Astro36/ICE3015-project/resource/project_note_0512.pdf

## 자이로가속도센서 브레드보드 조립

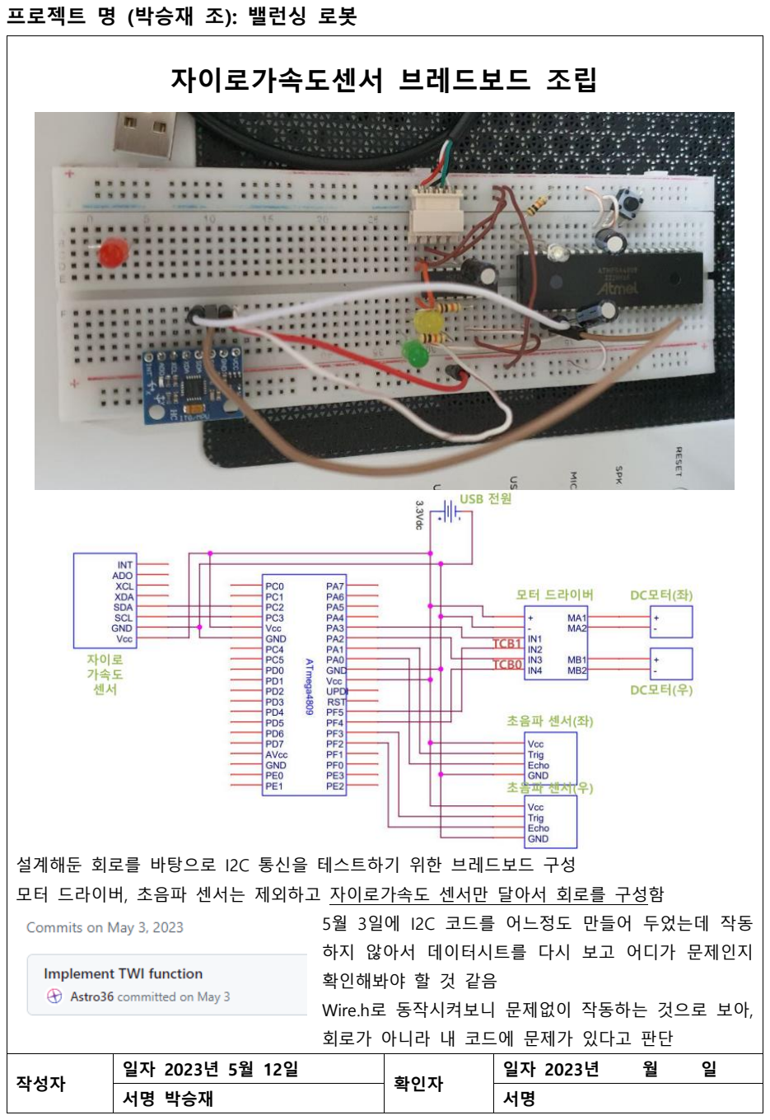
[picture p63: page 1]

프로젝트 명 (박승재 조): 밸런싱 로봇

설계해둔 회로를 바탕으로 I2C 통신을 테스트하기 위한 브레드보드 구성
모터 드라이버, 초음파 센서는 제외하고 자이로가속도 센서만 달아서 회로를 구성함 5월 3일에 I2C 코드를 어느정도 만들어 두었는데 작동 하지 않아서 데이터시트를 다시 보고 어디가 문제인지 확인해봐야 할 것 같음
Wire.h로 동작시켜보니 문제없이 작동하는 것으로 보아, 회로가 아니라 내 코드에 문제가 있다고 판단
작성자 | 일자 2023년 5월 12일 | 확인자 | 일자 2023년 월 일
| 서명 박승재 | | 서명
