Astro36/ICE3015-project/resource/project_note_0524.pdf

## PWM 출력 이슈 해결

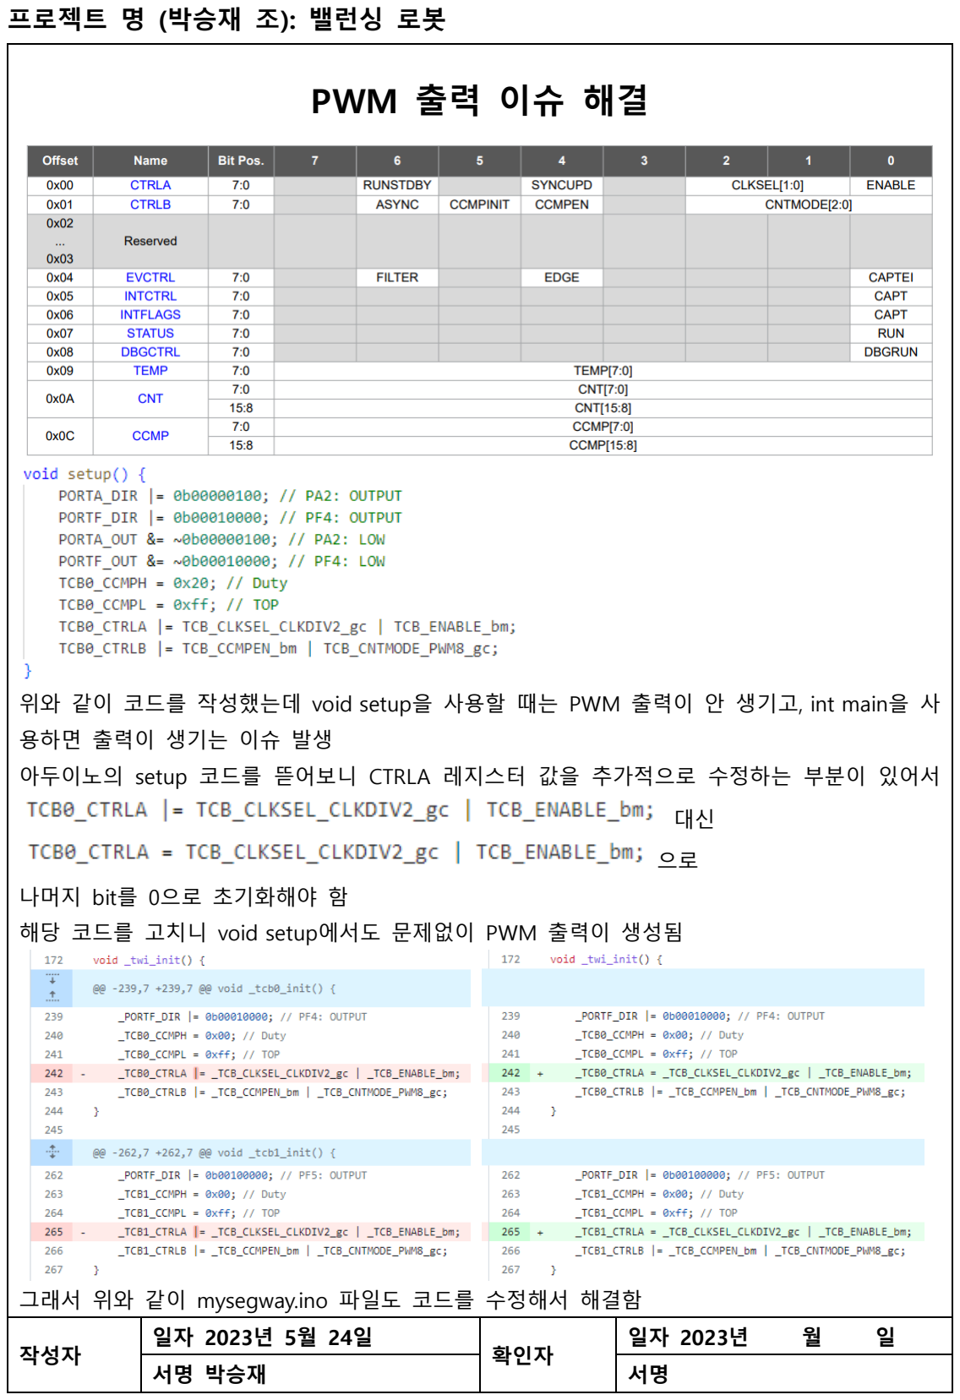
[picture p65: page 1]

프로젝트 명 (박승재 조): 밸런싱 로봇

위와 같이 코드를 작성했는데 void setup을 사용할 때는 PWM 출력이 안 생기고, int main을 사 용하면 출력이 생기는 이슈 발생
아두이노의 setup 코드를 뜯어보니 CTRLA 레지스터 값을 추가적으로 수정하는 부분이 있어서

대신

으로
나머지 bit를 0으로 초기화해야 함
해당 코드를 고치니 void setup에서도 문제없이 PWM 출력이 생성됨

그래서 위와 같이 mysegway.ino 파일도 코드를 수정해서 해결함
작성자 | 일자 2023년 5월 24일 | 확인자 | 일자 2023년 월 일
| 서명 박승재 | | 서명
