Astro36/ICE3015-project/resource/project_note_0604.pdf

## TCA0를 이용한 millis 구현

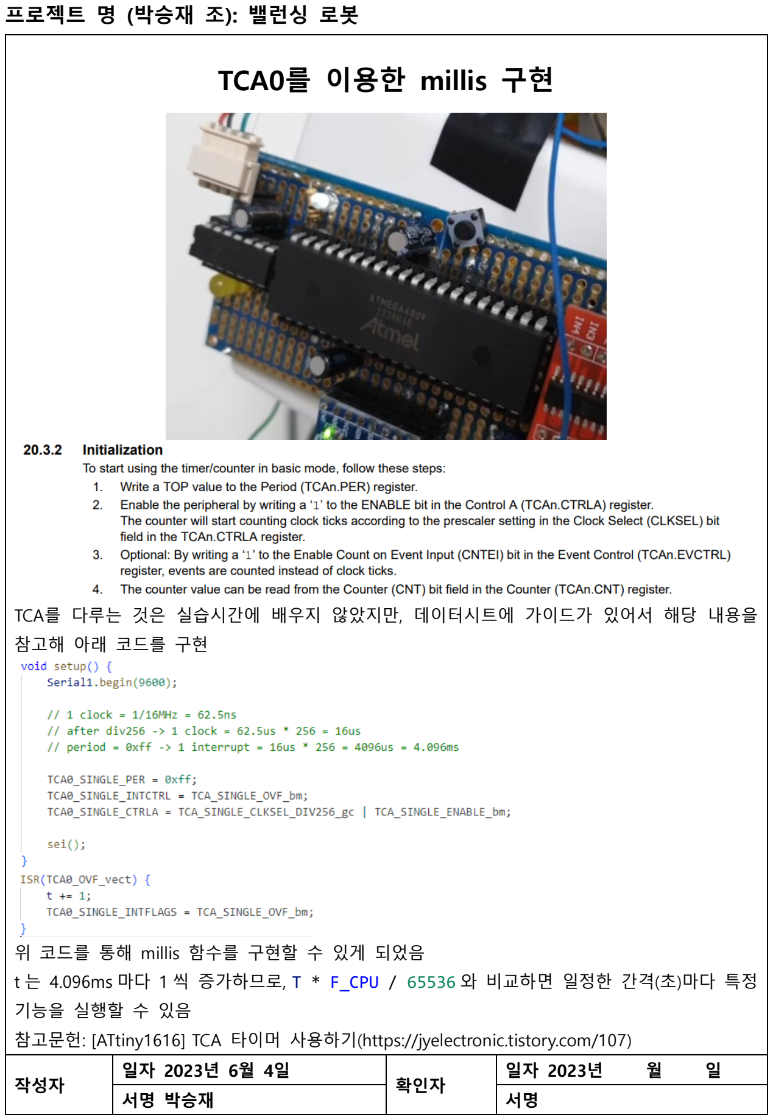
[picture p69: page 1]

프로젝트 명 (박승재 조): 밸런싱 로봇

TCA를 다루는 것은 실습시간에 배우지 않았지만, 데이터시트에 가이드가 있어서 해당 내용을 참고해 아래 코드를 구현

위 코드를 통해 millis 함수를 구현할 수 있게 되었음
t 는 4.096ms 마다 1 씩 증가하므로, T * F_CPU / 65536 와 비교하면 일정한 간격(초)마다 특정 기능을 실행할 수 있음
참고문헌: [ATtiny1616] TCA 타이머 사용하기(https://jyelectronic.tistory.com/107)
작성자 | 일자 2023년 6월 4일 | 확인자 | 일자 2023년 월 일
| 서명 박승재 | | 서명
