Astro36/ICE3015-project/resource/project_note_0613.pdf

프로젝트 명 (박승재 조): 밸런싱 로봇

## 레귤레이터와 배터리 장착, 그리고 전원 불안정

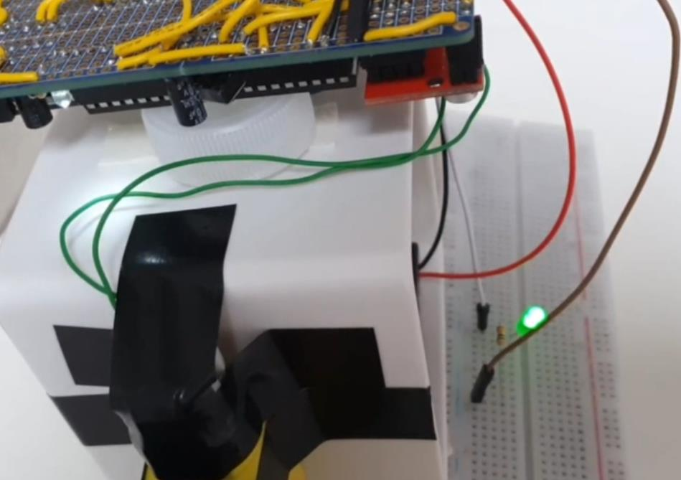
[picture p71: figure]

최종발표를 이틀 앞두고 조교님께 5V 레귤레이터를 받아서 로봇에 장착

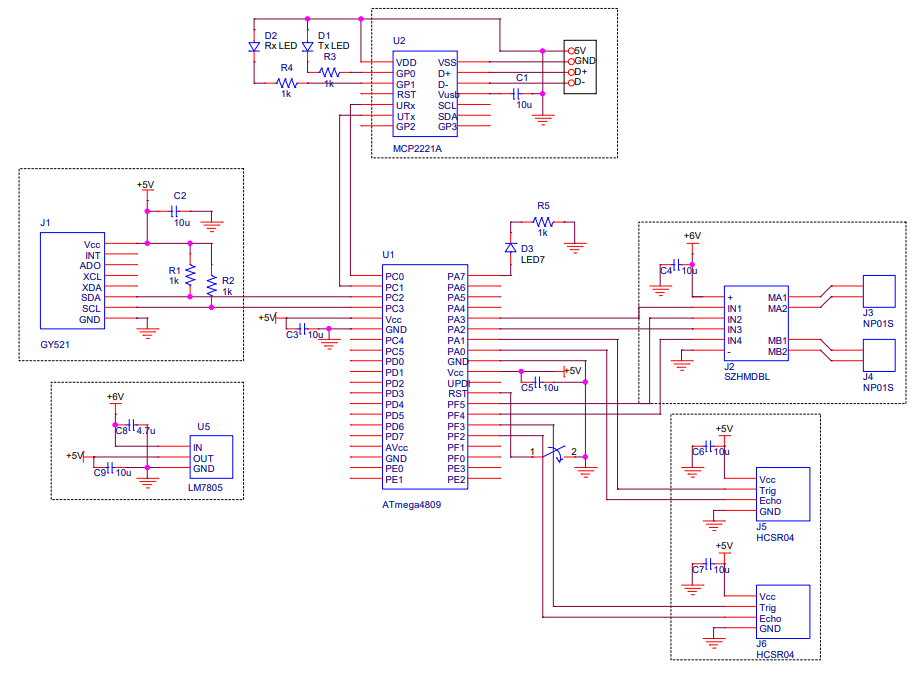
[picture p72: figure]

레귤레이터가 새로 생겼으므로, 회로도를 업데이트 했음
새로운 문제가 생겼는데, 모터를 장착할 때 다이오드를 달지 않아 모터로부터의 역기전력으로 시스템 전체의 전원이 불안정해짐, 모터가 작동하면 MCU가 리셋됨
5월 중 회로 피드백 기간에 발견하지 못한 문제라 상당히 당황스러움
최종발표 중 데모가 가능할 지 확신이 어렵지만 마지막까지 고치려고 시도해볼 예정
작성자 | 일자 2023년 6월 13일 | 확인자 | 일자 2023년 월 일
| 서명 박승재 | | 서명
