Astro36/ICE3015-project/resource/project_note_0609.pdf

프로젝트 명 (박승재 조): 밸런싱 로봇

## 만능기판 납땜 진행

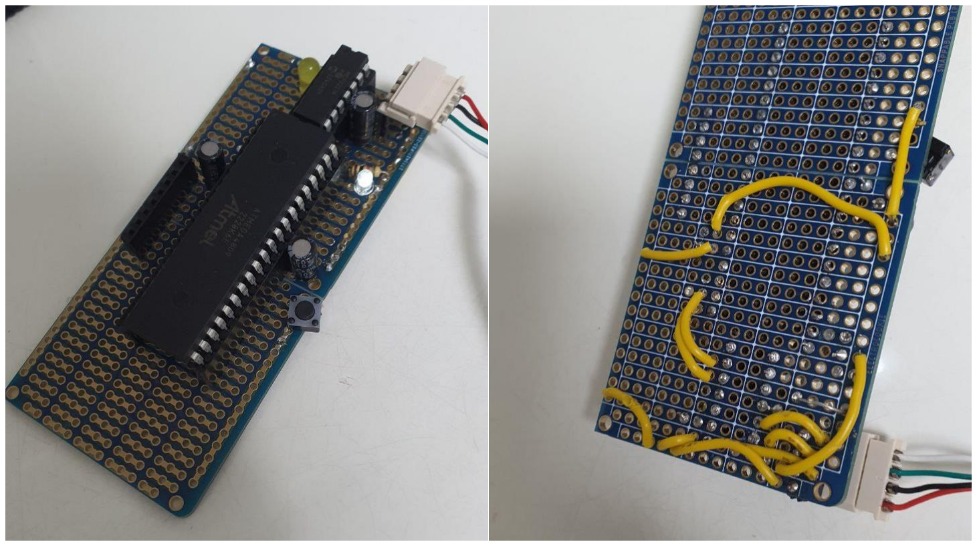
[picture p76: figure]

기존의 만능기판이 납땜 중 파손되어 더 사이즈가 큰 기판으로 다시 주문해서 납땜을 진행함 MCU와 USB 칩만 꽂아서 납땜이 정상적으로 되었는지 확인 후 기타 부품들을 진행

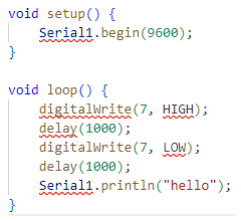
[picture p77: figure]

위 코드는 문제없이 작동하는 것으로 보아, MCU 부분까지는 문제가 없는 것으로 보임 이후 부품들도 납땜 진행 후 조교님께 검사받을 예정
작성자 | 일자 2023년 6월 9일 | 확인자 | 일자 2023년 월 일
| 서명 박승재 | | 서명
