Astro36/ICE3015-project/resource/orcad/circuit.pdf

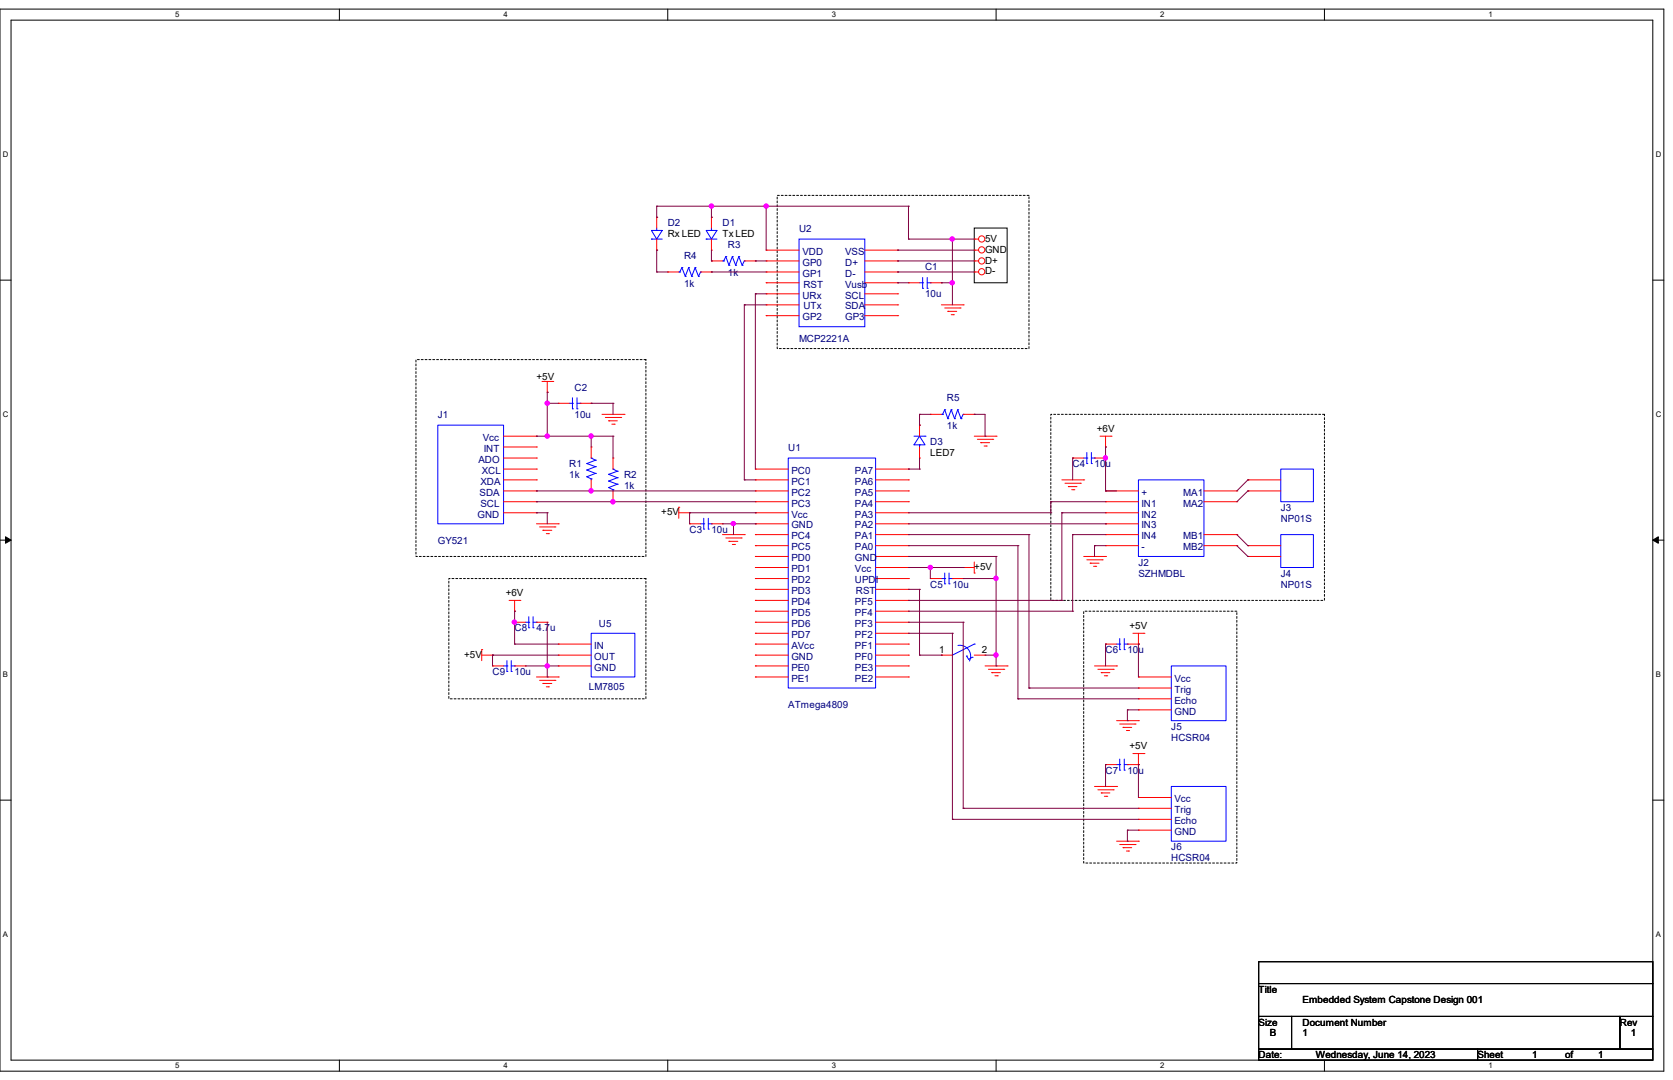
[picture p78: page 1]

J5HCSR04 Vcc Trig Echo GND

J6HCSR04 Vcc Trig Echo GND
