Astro36/ICE3015-project/(list of files, drawings)

Other design files:
resource/orcad/ESD.DSN
resource/orcad/ESD.opj
resource/orcad/LIBRARY3.OLB
