Astro36/ICE3015-project/(commit log)

2023-05-05 Implement complementary filter
2023-05-05 Implement PID controller
2023-05-08 Implement TCB PWM function
2023-05-08 Fix TWI read bug
    [mysegway.ino]
2023-05-09 Add arduino test code
2023-06-14 Update Wire.h test code
2023-06-14 Fix timer test code
    [test_tca0_timer.ino]
2023-06-14 Add OrCAD file
    [ESD.DSN, ESD.opj, LIBRARY3.OLB]
2023-06-14 Add circuit image
2023-06-14 Rename directory
    [ESD.DSN, ESD.opj, LIBRARY3.OLB]
